cxs1529/radiometer-aoml/Radiometer PCB/3D images/Radiometer amps r2b.jpg

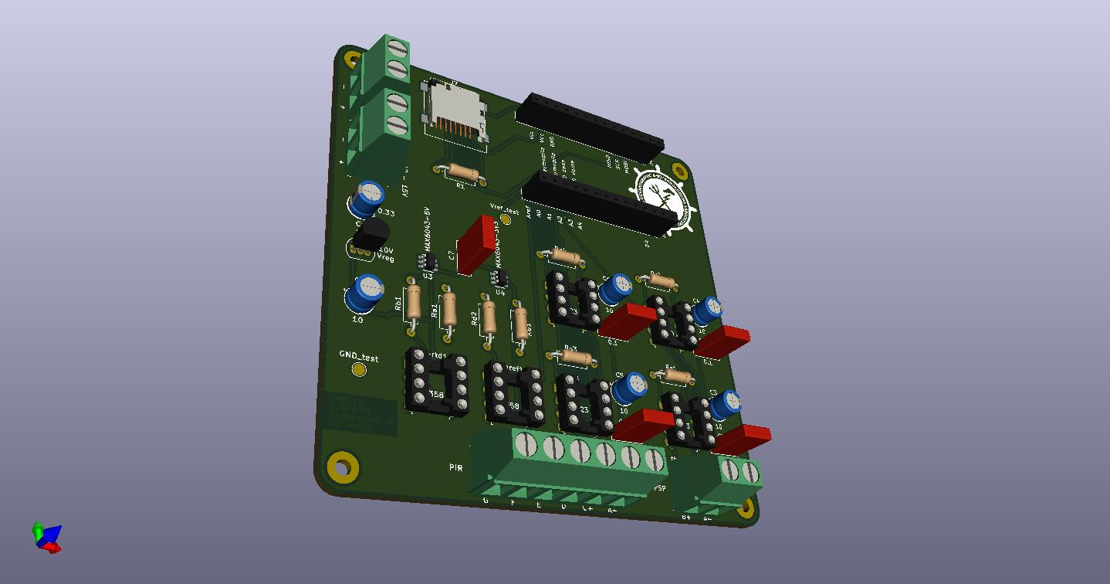
Radiometer PCB/3D images/Radiometer amps r2b.jpg
