cxs1529/radiometer-aoml/Radiometer PCB/3D images/Radiometer amps r2a.jpg

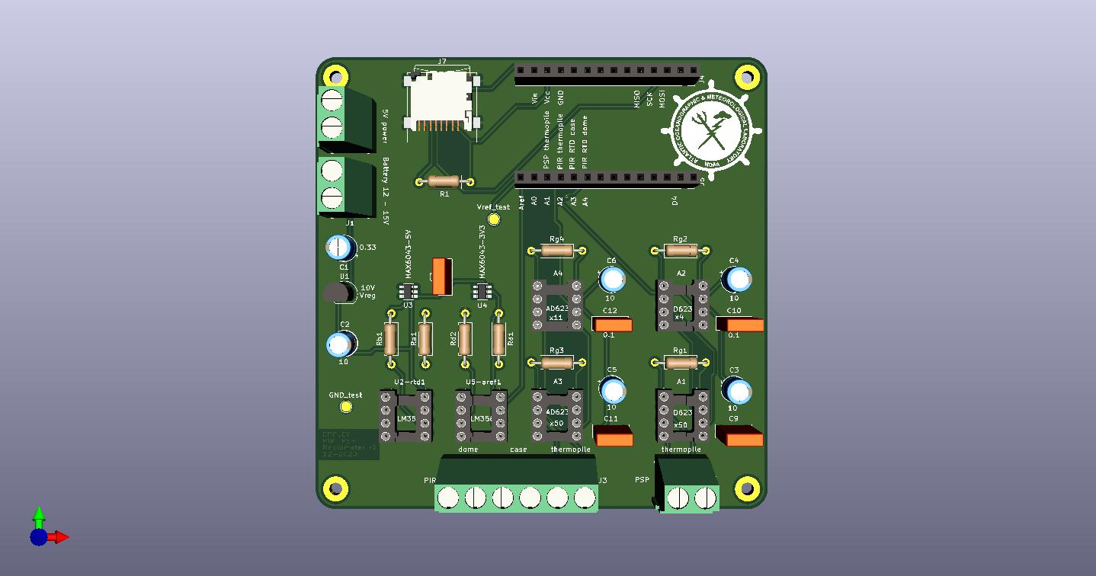
Radiometer PCB/3D images/Radiometer amps r2a.jpg
