cxs1529/radiometer-aoml/README.md

# radiometer-aoml
firmware for Eppley radiometer system prototype

Current repository has 3 separate versions of the radiometer system firmware based on ATMEL-microcontrollers
