cxs1529/radiometer-aoml/(list of files, drawings)

Other design files:
Radiometer PCB/Radiometer amps r2.dsn
