cxs1529/radiometer-aoml/Radiometer PCB/Radiometer amps r3.kicad_pcb

## KiCad design Radiometer PCB/Radiometer amps r3.kicad_pcb (2024-10-14)

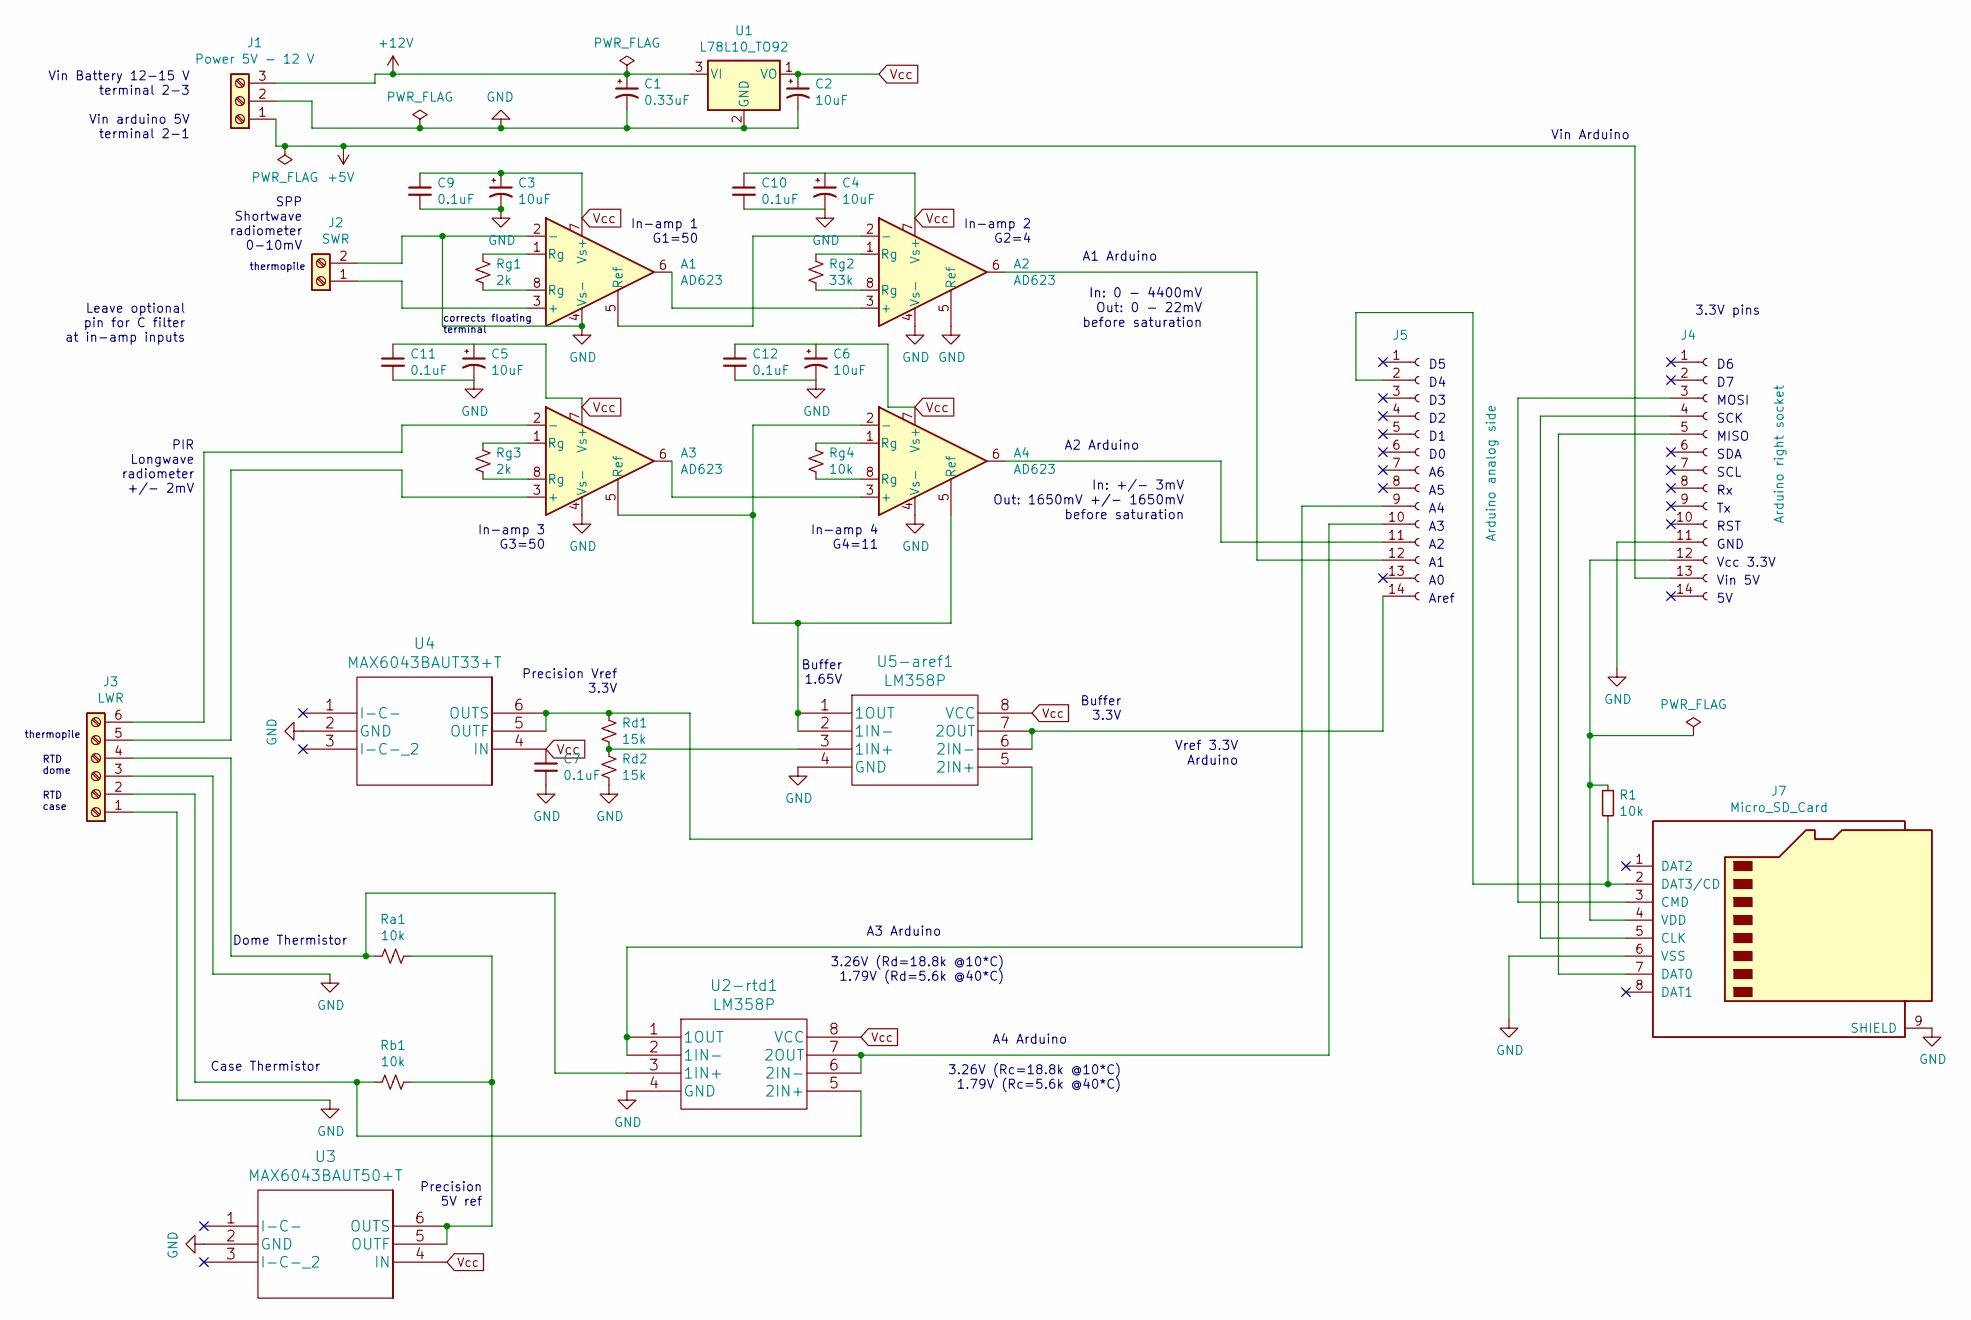
[picture p4: schematic Radiometer amps r3.sch]

Parts:
A1, A2, A3, A4: AD623; DIP-8_W7.62mm
C1: 0.33uF; CP_Radial_D5.0mm_P2.00mm
C2, C3, C4, C5, C6: 10uF; CP_Radial_D5.0mm_P2.00mm
C7, C9, C10, C11, C12: 0.1uF; C_Rect_L7.0mm_W2.5mm_P5.00mm
J1: Power 5V - 12 V; Term_Block_1x3_P5mm
J2: SWR; Term_Block_1x2_P5mm
J3: LWR; Term_Block_1x6_P5mm
J4: Arduino right socket; PinSocket_1x14_P2.54mm_Vertical
J5: Arduino analog side; PinSocket_1x14_P2.54mm_Vertical
J7: Micro_SD_Card; microSD_HC_Wuerth_693072010801
R1: 10k; R_Axial_DIN0207_L6.3mm_D2.5mm_P10.16mm_Horizontal
Ra1: 10k; R_Axial_DIN0207_L6.3mm_D2.5mm_P10.16mm_Horizontal
Rb1: 10k; R_Axial_DIN0207_L6.3mm_D2.5mm_P10.16mm_Horizontal
Rd1, Rd2: 15k; R_Axial_DIN0207_L6.3mm_D2.5mm_P10.16mm_Horizontal
Rg1, Rg3: 2k; R_Axial_DIN0207_L6.3mm_D2.5mm_P10.16mm_Horizontal
Rg2: 33k; R_Axial_DIN0207_L6.3mm_D2.5mm_P10.16mm_Horizontal
Rg4: 10k; R_Axial_DIN0207_L6.3mm_D2.5mm_P10.16mm_Horizontal
U1: L78L10_TO92; TO-92_Inline
U2-rtd1, U5-aref1: LM358P; DIP-8_W7.62mm
U3: MAX6043BAUT50+T; MAX6043AAUT33-G16
U4: MAX6043BAUT33+T; MAX6043AAUT33-G16

Connections:
+5V: J1.1, J4.13
+12V: C1.1, J1.3, U1.3 (VI)
GND: A1.2 (-), A1.4 (Vs-), A2.4 (Vs-), A2.5 (Ref), A3.4 (Vs-), A4.4 (Vs-), C1.2, C2.2, C3.2, C4.2, C5.2, C6.2, C7.2, C9.2, C10.2, C11.2, C12.2, J1.2, J2.2, J3.1, J3.3, J4.11, J7.6 (VSS), J7.9 (SHIELD), Rd2.2, U1.2 (GND), U2-rtd1.4 (GND), U3.2 (GND), U4.2 (GND), U5-aref1.4 (GND)
unnamed: A1.1 (Rg), Rg1.1
unnamed: A1.3 (+), J2.1
unnamed: A1.5 (Ref), A2.2 (-)
unnamed: A1.6, A2.3 (+)
unnamed: A1.8 (Rg), Rg1.2
unnamed: A2.1 (Rg), Rg2.1
unnamed: A2.6, J5.12
unnamed: A2.8 (Rg), Rg2.2
unnamed: A3.1 (Rg), Rg3.1
unnamed: A3.2 (-), J3.6
unnamed: A3.3 (+), J3.5
unnamed: A3.5 (Ref), A4.2 (-), A4.5 (Ref), U5-aref1.1 (1OUT), U5-aref1.2 (1IN-)
unnamed: A3.6, A4.3 (+)
unnamed: A3.8 (Rg), Rg3.2
unnamed: A4.1 (Rg), Rg4.1
unnamed: A4.6, J5.11
unnamed: A4.8 (Rg), Rg4.2
unnamed: J3.2, Rb1.1, U2-rtd1.5 (2IN+)
unnamed: J3.4, Ra1.1, U2-rtd1.3 (1IN+)
unnamed: J4.3, J7.3 (CMD)
unnamed: J4.4, J7.5 (CLK)
unnamed: J4.5, J7.7 (DAT0)
unnamed: J4.12, J7.4 (VDD), R1.1
unnamed: J5.2, J7.2 (DAT3/CD), R1.2
unnamed: J5.9, U2-rtd1.1 (1OUT), U2-rtd1.2 (1IN-)
unnamed: J5.10, U2-rtd1.6 (2IN-), U2-rtd1.7 (2OUT)
unnamed: J5.14, U5-aref1.6 (2IN-), U5-aref1.7 (2OUT)
unnamed: Ra1.2, Rb1.2, U3.5 (OUTF), U3.6 (OUTS)
unnamed: Rd1.1, U4.5 (OUTF), U4.6 (OUTS), U5-aref1.5 (2IN+)
unnamed: Rd1.2, Rd2.1, U5-aref1.3 (1IN+)
Vcc: A1.7 (Vs+), A2.7 (Vs+), A3.7 (Vs+), A4.7 (Vs+), C2.1, C3.1, C4.1, C5.1, C6.1, C7.1, C9.1, C10.1, C11.1, C12.1, U1.1 (VO), U2-rtd1.8 (VCC), U3.4 (IN), U4.4 (IN), U5-aref1.8 (VCC)

Notes on the sheet:
A2 Arduino
A1 Arduino
Buffer 3.3V
Buffer 1.65V
Precision Vref 3.3V
Vref 3.3V Arduino
In-amp 4 G4=11
In-amp 3 G3=50
PIR Longwave radiometer +/- 2mV
In-amp 2 G2=4
In-amp 1 G1=50
SPP Shortwave radiometer 0-10mV
A3 Arduino
A4 Arduino
In: 0 - 4400mV Out: 0 - 22mV before saturation
In: +/- 3mV Out: 1650mV +/- 1650mV before saturation
Case Thermistor
Dome Thermistor
3.26V (Rc=18.8k @10*C) 1.79V (Rc=5.6k @40*C)
3.26V (Rd=18.8k @10*C) 1.79V (Rd=5.6k @40*C)
Vin Arduino
Leave optional pin for C filter at in-amp inputs
thermopile
RTD case
RTD dome
Aref
Vin 5V
Vcc 3.3V
GND
Precision 5V ref
RST
SCL
SDA
MISO
SCK
MOSI
3.3V pins
Vin Battery 12-15 V terminal 2-3 Vin arduino 5V terminal 2-1
corrects floating terminal

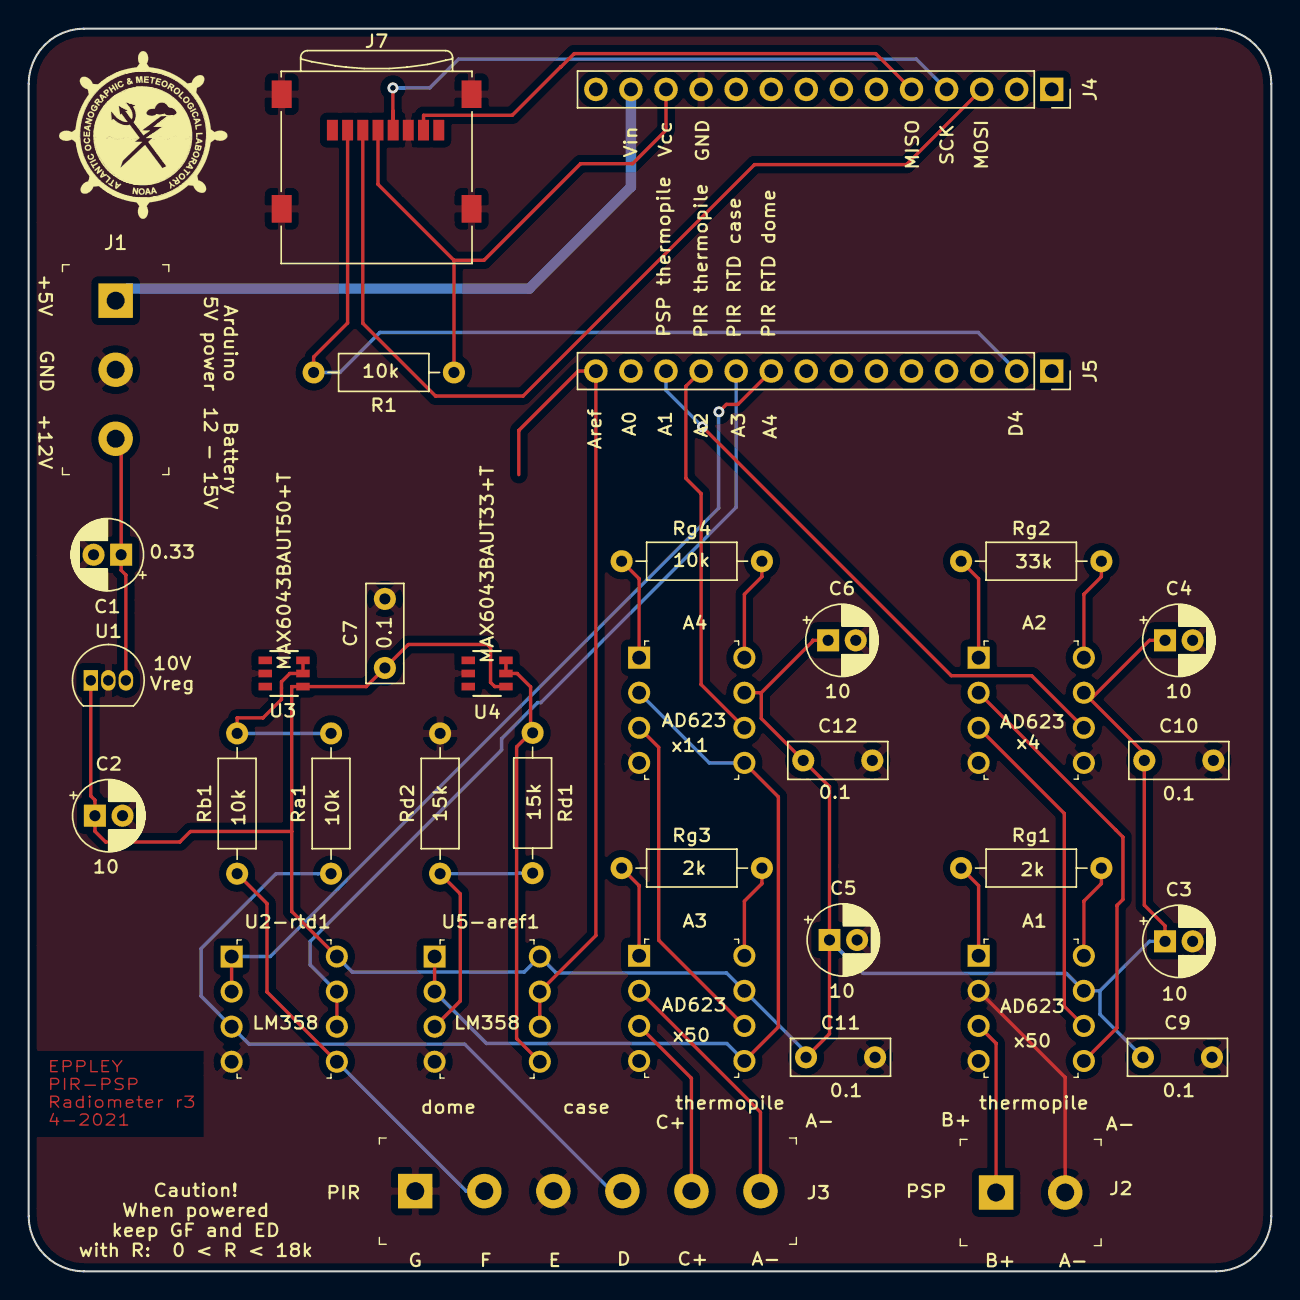
[picture p5: board Radiometer amps r3.kicad_pcb from above]

Board: 2 copper layers, 90.0 x 90.0 mm, 35 parts (0 on the bottom side), 34 nets.
