cxs1529/radiometer-aoml/FTP server upload/arduino_secrets.h

#define SECRET_PINNUMBER     "0000"
#define SECRET_GPRS_APN      "data.lycamobile.com" // replace your GPRS APN
#define SECRET_GPRS_LOGIN    "" // replace with your GPRS login
#define SECRET_GPRS_PASSWORD "" // replace with your GPRS password

//FTP server 1 (working): https://dlptest.com/ftp-test/
// Use filezilla client for testing

#define SECRET_FTP_HOST             "ftp.dlptest.com"  // replace with your FTP host server
#define SECRET_FTP_USER             "dlpuser@dlptest.com"  // replace with your FTP user
#define SECRET_FTP_PASSWORD         "SzMf7rTE4pCrf9dV286GuNe4N"  // replace with your FTP password
#define SECRET_FTP_PORT             21  // replace with your FTP port (optional)
#define SECRET_FTP_REMOTE_DIR       "/rad" // replace with your FTP default remote directory


/*
//FTP server 2 (didn't work well): https://www.drivehq.com/
// Free private server up to 5 GB storage
*/

/*
//FTP server 3 (working): https://royalwebhosting.net/
*/
