cxs1529/radiometer-aoml/(commit log)

2020-03-30 Upload of version 3 prototype variants
    rtc_and_sd_working - refers to the last stable/deployed version of firmware for the radiometer system
    RTCSD_Gain - refers to an update made for gain non-linearity compensation
    rtc_and_sd_working_REVA - refers to a restructured version of "rtc_and_sd_working" based on OOD
2020-04-02 RTCSD gain condition error fixed
    [Data_logger_Radiometer_v3_RTCSD_Gain.ino]
2020-04-14 Add files via upload
    This code is based on the MKRGSM FTP library: https://github.com/tryhus/MKRGSM/tree/feature/ftp
    An Arduino MKR GSM 1400 with a SIM card with internet is needed for this project.
    The program reads 2 analog values and with a time stamp creates a string with a fixed format MMDDYYhhmmssAAAABBBB every second (this can be changed in line 239).
    The string may be "compressed" to reduce data traffic, changing the number's base, from decimal to other base like hexadecimal or base 36 (using 0-9...A-Z). The latter will reduce the Max number of 12319923595999999999 (20 char) to DDDDTTTTAAAAAAAA ( 14 char -30%). Convert Dat, time and analog values before, adding a '1' as he MS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
    [FTPv4.ino, arduino_secrets.h]
2020-04-14 FTP upload
    The string may be "compressed" to reduce data traffic, changing the number's base, from decimal to other base like hexadecimal or base 36 (using 0-9...A-Z). The latter will reduce the Max number of 12319923595999999999 (20 char) to DDDDTTTTAAAAAAAA ( 14 char -30%). Convert Dat, time and analog values before, adding a '1' as he MSD to keep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
    [FTPv4.ino, arduino_secrets.h]
2024-10-14 KiCAD files uploaded
    [Radiometer amps r2-B_Cu.gbr, Radiometer amps r2-B_Mask.gbr, Radiometer amps r2-B_SilkS.gbr, Radiometer amps r2-Edge_Cuts.gbr, Radiometer amps r2-F_Cu.gbr, Radiometer amps r2-F_Mask.gbr, Radiometer amps r2-F_SilkS.gbr, Radiometer amps r2-job.gbrjob]
